fancyguyiitb/iot-smart-energy-meter/others/README.md

We have 1 files showing MCB connections between mcb, contactor and load and other jpg file demonstrating Power backup circuit
