fancyguyiitb/iot-smart-energy-meter/3d_models/PCB_MOUNT_DESIGN/README.md

# Mount Design

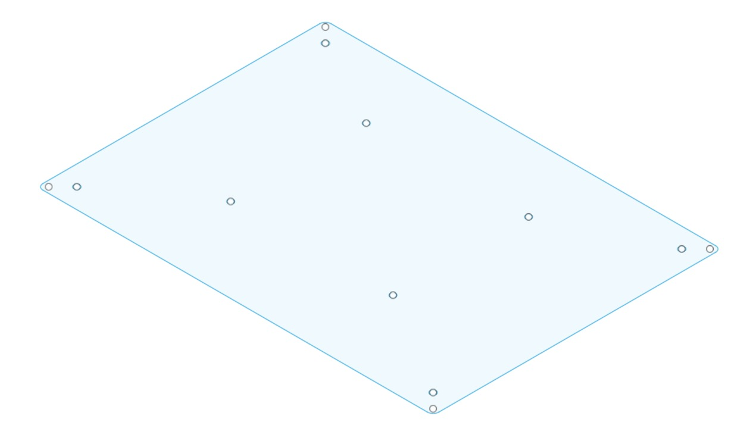
[picture p1: 3d_models/PCB_MOUNT_DESIGN/picture.jpeg]


This folder contains the DXF files for the PCB mount design.
The design is based on the PCB dimensions and includes mounting holes for screws.
