fancyguyiitb/iot-smart-energy-meter/3d_models/POWER_BACKUP/README.md

# Power Backup Design

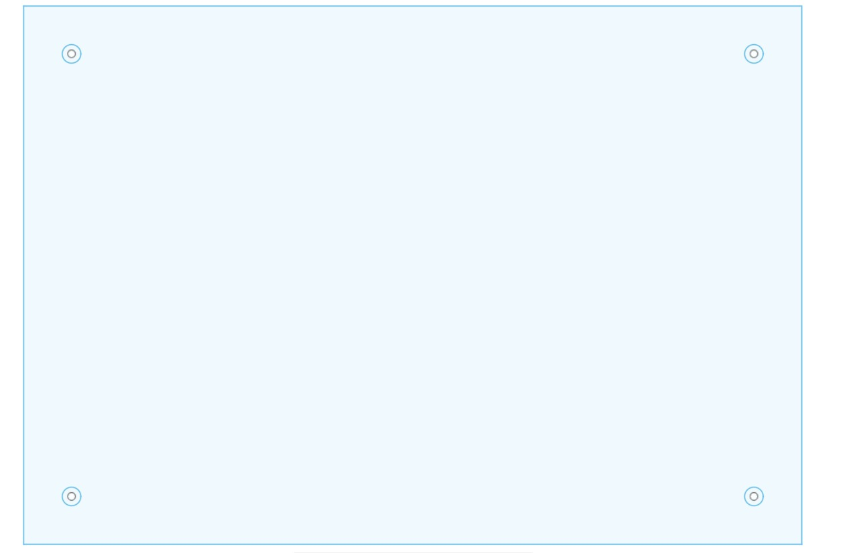
[picture p2: 3d_models/POWER_BACKUP/picture.jpeg]


This folder contains the DXF files for the Power Backup design.
The design is based on the PCB dimensions and includes mounting holes for screws.
