fancyguyiitb/iot-smart-energy-meter/src/Application/README.md

# ⚡ Voltix – Smart Energy Meter App

Voltix is a mobile app for monitoring and controlling a 3-phase IoT-based smart energy meter.

---

## 🔍 Features

- Live voltage, current, power & THD readings
- Remote supply control via relay
- Analytics on consumption & power quality
- Cloud storage with historical trends

---

## 🚀 Getting Started

```bash
git clone https://github.com/your-username/voltix.git
cd voltix
flutter pub get
flutter run
```

---

## 📦 Build APK

```bash
flutter build apk --release
```
