fancyguyiitb/iot-smart-energy-meter/others/mcb_connections.jpg

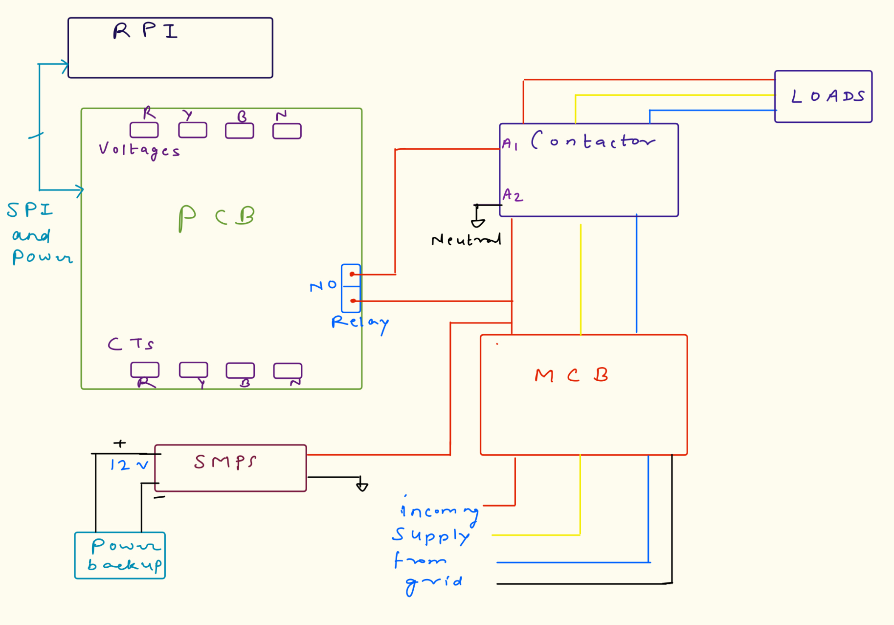
others/mcb_connections.jpg
