fancyguyiitb/iot-smart-energy-meter/others/power_backup_connections.jpg

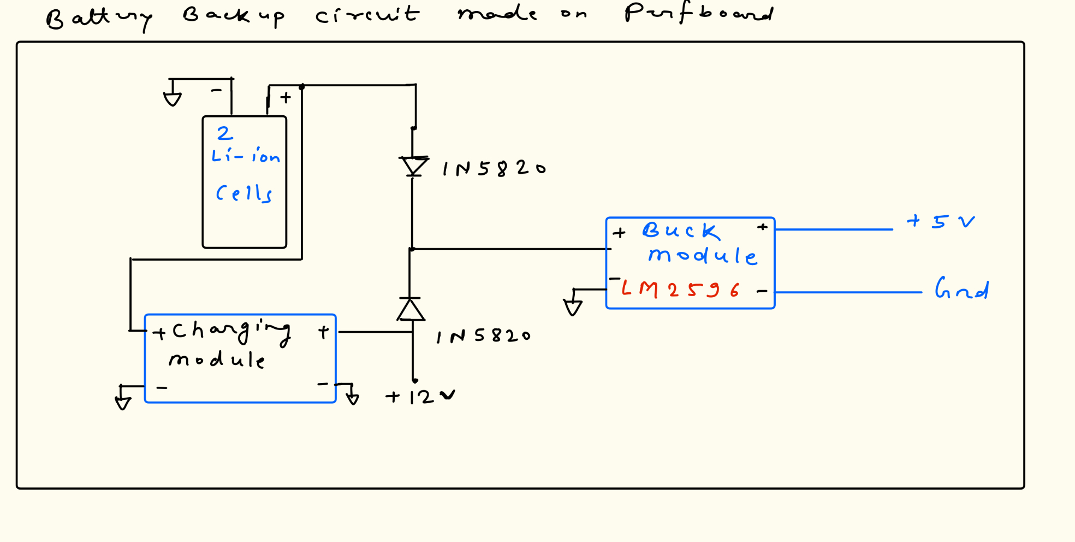
others/power_backup_connections.jpg
