fancyguyiitb/iot-smart-energy-meter/pcb/EDL_TUE_17/pcb.jpg

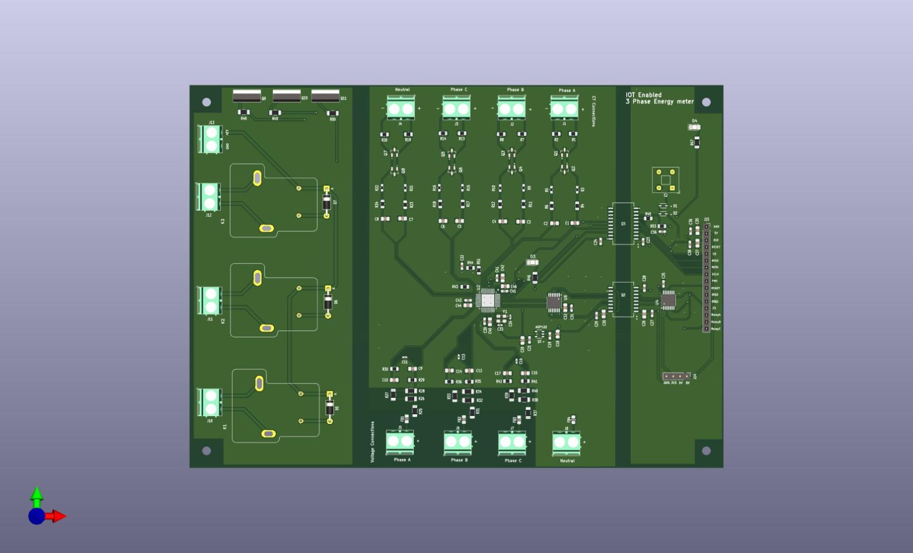
pcb/EDL_TUE_17/pcb.jpg
