fancyguyiitb/iot-smart-energy-meter/src/RPi/pages/cherish.jpg

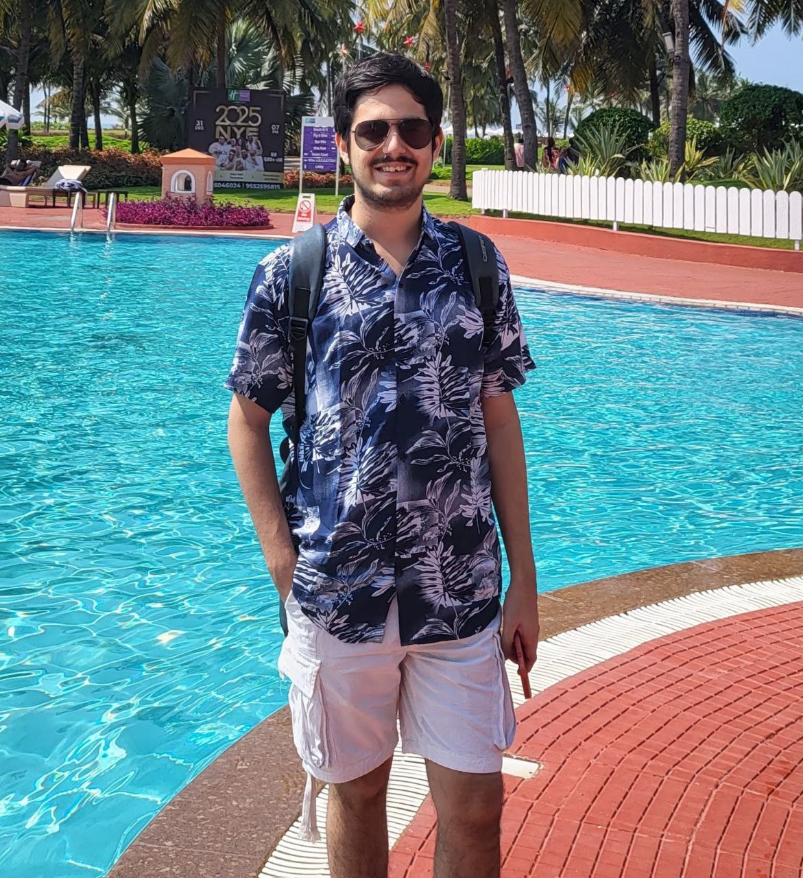
src/RPi/pages/cherish.jpg
