fancyguyiitb/iot-smart-energy-meter/src/RPi/spinner.gif

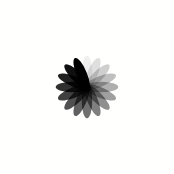
src/RPi/spinner.gif
