fancyguyiitb/iot-smart-energy-meter/bom.xls

Project Title: IoT enabled 3-phase power quality and energy meter for laboratory power analysis
Group ID: TUE-17
Name of the Group Member/s: Saurabh Kumar, Sarthak Niranjan, Aryan Tamboli, Cherish Jain, Ayush Gaur
Contact details of the Group Member responsible for BOM: 7898169485, 22b3927@iitb.ac.in
BOM
Sr.No | Usage (Name of the "Circuit block/Functional block" in which components is used) | Part description (OpAMP,ADC,DAC etc) | Manufacturing Part Number | Package type/Footprint | Availiabile in WEL? | WEL Component stock Location-ID | Vendor | Stock Availiability (With Vendor) | Link (Vendor online website) | Required Qty + Spare | Cost per each item | Total Cost
1 | Current Sensing | Current Transformers Current Transformer 100A 1:2500 97Henry | 983-T60404-E4626X002 | Not to be mounted on PCB | YES | 2K.BOX-8.2 | Mouser | In-Stock | https://www.mouser.in/ProductDetail/Vacuumschmelze/T60404-E4626-X002?qs=EPkW%252BsqxegG82U7INiKINw%3D%3D | 4 | 440.35 | 1761
2 | Power Monitoring | ANALOG DEVICES Monitoring IC, Energy and Power Quality, Multiphase, 2.97 to 3.63 V, -40 to 85 Deg C, LFCSP-EP-40 | ADE9000ACPZ | 40-pin LFCSP (6 x 6) | YES | 2K.BOX-9.55 | Mouser | In-Stock | https://www.mouser.in/ProductDetail/Analog-Devices/ADE9000ACPZ?qs=OpCP5Wdiozdy7qaFsotrPg%3D%3D&gad_source=1 | 1 | 1537.9 | 1537.9
3 | Power Management | ANALOG DEVICES LDO Voltage Regulator, Fixed, 2.3 V to 5.5 V in, 3.3 V out, 0.3 A out, TSOT-5 | ADP122AUJZ-3.3-R7 | 5 lead TSOT | YES | 2K.BOX-9.17 | Digi Key | In-Stock | https://www.digikey.in/en/products/detail/analog-devices-inc/ADP122AUJZ-3-3-R7/2237672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 | 1 | 195.83 | 195.83
4 | SPI Isolator | ANALOG DEVICES Optical Components, 7 Channels, 3 V, 5.5 V, WSOIC, 20 Pins, 34 Mbps | ADUM4151BRIZ | 20 lead SOIC | YES | 2K.BOX-9.62 | Digi Key | In-Stock | https://www.digikey.in/en/products/detail/analog-devices-inc/ADUM4151BRIZ/5031786 | 1 | 1180.48 | 1180.48
5 | Optical Components | ANALOG DEVICES Optical Components, 4 Channels, 3 V, 5.5 V, SOIC, 16 Pins, 1 Mbps | ADUM6404ARIZ | 16 lead SOIC | YES | 2K.BOX-9.63 | Mouser | In-Stock | https://www.mouser.in/ProductDetail/Analog-Devices/ADUM6404ARIZ?qs=WIvQP4zGanhHzx9OCAfFww%3D%3D | 1 | 1322.72 | 1322.72
6 | Level Shifter | IC BUF NON-INVERT 5.5V 14TSSOP | SN74LV4T125PWR | 14TSSOP | YES | 2K.BOX-8.41 | Digi Key | In-Stock | https://www.digikey.in/en/products/detail/texas-instruments/SN74LV4T125PWR/4806529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 | 2 | 67.53 | 135.06
7 | Single Board Computer | Raspberry Pi 5 |  |  | NO |  |  | In-Stock | https://robu.in/product/raspberry-pi-5-model-4gb/?gad_source=1 | 1 | 5549 | 6149
8 | Display | Raspberry Pi display 7" with capacitive touch |  |  | NO |  |  | In-Stock | https://robu.in/product/waveshare-7inch-800x480-capacitive-touch-display-for-raspberry-pi-dsi-interface/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 | 1 | 4199 | 4199
9 | Resistors (SMD) | Resistor | 0E (0805) | SMD 0805 | YES | 2M |  |  |  | 17 | 0.1 | 1.7
10 | Resistors (SMD) | Resistor | 10K | SMD 0805 | YES | 2M |  | In-Stock | https://robu.in/product/rc0805fr-0710kl-yageo-res-thick-film-0805-10k-ohm-1-0-125w1-8w-%C2%B1100ppm-c-pad-smd-t-r/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 | 8 | 0.35 | 2.8
11 | Resistors (SMD) | Resistor | 1K | SMD 0805 | YES | 2M |  | Out of Stock | https://robu.in/product/rc0805fr-071kl-yageo-res-thick-film-0805-1k-ohm-1-0-125w1-8w-%C2%B1100ppm-c-pad-smd-t-r/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 | 15
12 | Resistors (SMD) | Resistor | 200K | SMD 0805 | YES | 2M |  | In-Stock | https://robu.in/product/rc0805fr-07200kl-yageo-res-thick-film-0805-200k-ohm-1-0-125w1-8w-%C2%B1100ppm-c-pad-smd-t-r/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 | 12 | 0.35 | 4.2
13 | Resistors (SMD) | Resistor | 5.1 (0805) | SMD 0805 | YES | 2M |  | In-Stock | https://evelta.com/5-1e-5-0805-smd-resistor-royal-ohm-0805s8j051jt5e/?gad_source=1 | 8 | 1.68 | 13.44
14 | Resistors (SMD) | Resistor | 3 kΩ, 0.1 W | SMD 0805 | NO |  |  | In-Stock | https://robu.in/product/rc0805fr-073kl-yageo-res-thick-film-0805-3k-ohm-1-0-125w1-8w-%C2%B1100ppm-c-pad-smd-t-r/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 | 5 | 0.35 | 1.75
15 | Capacitor (SMD) | Capacitor | 22 nF, 50V (0805) | SMD 0805 | NO |  |  | In-Stock | https://robu.in/product/tcc0805x7r223k501ft-cctc-smt-ceramic-capacitors-0805-x7r-223k22nf%C2%B110-rated-voltage500v-thickness1-25mmtape/ | 12 | 3 | 36
16 | Capacitor (SMD) | Capacitor | 100NF, 25V (0805) | SMD 0805 | NO |  |  | In-Stock | https://robu.in/product/c0805x104k3racauto-kemet-smd-multilayer-ceramic-capacitor-0-1-%C2%B5f-25-v-0805-2012-metric-%C2%B1-10-x7r/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 | 19 | 0.26 | 4.94
17 | Capacitor (SMD) | Capacitor | 10UF, 16V (0805) | SMD 0805 | NO |  |  | In-Stock | https://robu.in/product/cl21a106kofnnne-samsang-16v-10uf-x5r-%C2%B110-0805-multilayer-ceramic-capacitors-mlcc-smd-smt-rohs/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 | 8 | 0.98 | 7.84
18 | Capacitor (SMD) | Capacitor | 1UF, 50V (0805) | SMD 0805 | NO |  |  | In-Stock | https://robu.in/product/cl21b105kbfnfne-samsang-50v-1uf-x7r-%C2%B110-0805-multilayer-ceramic-capacitors-mlcc-smd-smt-rohs/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 | 2 | 1.06 | 2.12
19 | Capacitor (SMD) | Capacitor | 22UF, 25V (0805) | SMD 0805 | NO |  |  | In-Stock | https://robu.in/product/cl21a226maynnwe-samsang-25v-22uf-x5r-%C2%B120-0805-multilayer-ceramic-capacitors-mlcc-smd-smt-rohs/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 | 1 | 3 | 3
20 | Capacitor (SMD) | Capacitor | 18 pF, 50V (0805) | SMD 0805 | NO |  |  | In-Stock | https://robu.in/product/tcc0402cog180f500at-cctc-smt-ceramic-capacitors-0402-cog-180f18pf%C2%B11-0-rated-voltage50v-thickness0-50mm-tape/ | 2 | 0.35 | 0.7
21 | Capacitor (SMD) | Capacitor | 4.7 UF, 25 V (0805) | SMD 0805 | NO |  |  | In-Stock | https://robu.in/product/cs2012x5r475k250nre-samwha-25v-4-7uf-x5r-%C2%B110-0805-multilayer-ceramic-capacitors-mlcc-smd-smt-rohs/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 | 6 | 1.03 | 6.18
22 | Capacitor (SMD) | Capacitor | 51 pF, 50 V | SMD 0402 | NO |  |  | In-Stock | https://robu.in/product/tcc0402cog510j500at-cctc-smt-ceramic-capacitors-0402-cog-510j51pf%C2%B15-0-rated-voltage50v-thickness0-50mm-tape/ | 3 | 0.12 | 0.36
23 | Ferrite Bead | Ferrite Bead 1500 Ohm | BLM21BD152SN1D | SMD 0805 | NO |  |  | In-Stock | https://www.digikey.in/en/products/detail/murata-electronics/BLM21BD152SN1D/584258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 | 4 | 18.12 | 72.48
24 | Diodes | MULTICOMP PRO Small Signal Schottky Diodes, Single, 30 V, 300 mA, 1 V, 600 mA, 125 Â°C | BAT54WS | SOD-323 | YES | 2K.BOX-9.110 |  |  | https://www.vishay.com/docs/85667/bat54ws.pdf | 2
25 | Crystal Oscillator (Clock for ADE Chip) | Crystal, 24.576 MHz, 12 pF | ECS-245.7-12-33Q-JES-TR | 4-SMD | NO |  |  | In-Stock | https://www.digikey.com/en/products/detail/ecs-inc/ECS-245-7-12-33Q-JES-TR/6050970 | 1 | 75 | 75
26 | Diodes | Diodes, dual series connection, 100 V | MMBD4148SE | SOT-23-3 | YES | 2K.BOX-9.65 |  | In-Stock | https://www.mouser.in/ProductDetail/onsemi-Fairchild/MMBD4148SE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 | 8 | 10.84 | 86.72
27 | Connectors (Voltage and Current Connections) | 2 pin screw terminal | XY128VC-5.0-XINYA-2 Pin Screw | THT | YES | 2L.Box-4, 15.54 |  | In-Stock | https://robu.in/product/xy128vc-5-0-xinya-2-pin-screw-terminal-blockgreen/?gad_source=4 | 10 | 11 | 110
28 | Switch (RESET) | SWITCH TACTILE SPST-NO 0.05A 12V | 2223-TS02-66-50-BK-100-LCR-D-ND | THT | YES | 2K.BOX-8.63 |  | In-Stock | TS02-66-50-BK-100-LCR-D Same Sky (Formerly CUI Devices) | Switches | DigiKey (https://www.digikey.in/en/products/detail/same-sky-formerly-cui-devices/TS02-66-50-BK-100-LCR-D/15634294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) | 1 | 11.22 | 11.22
29 | Connector (For Power Input) | Micro USB 2.0 B Type 5 Pin Connector | CONN RCPT USB2.0 MICRO B SMD R/A | SMD | YES | 2K.BOX-9.138 |  | In-Stock | https://www.digikey.in/en/products/detail/amphenol-icc-fci/10118194-0001LF/2785389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 | 1 | 35.37 | 35.37
30 | Relay (To Turn on/off load) | Relay High Current | T9VV1K15-12S | THT | NO |  |  | In-Stock | https://robu.in/product/t9vv1k15-12s-potterbrumfield-te-connectivity-t9vv1k15-12s-power-relay-spst-no-12vdc-40a-th/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 | 3 | 211 | 633
31 | Transistor (For Relay Drive) | BC547 | BC547 NPN Transistor | THT | YES | 2L.BOX-3.8 |  | In-Stock | https://robu.in/product/bc547-npn-transistor-pack-of-20/?gad_source=4 | 5 | 2 | 10
32 | charging module HW370 TP5100 |  |  |  | YES |  |  |  |  | 1
33 | diodes |  | 1n5820 |  | YES |  |  |  |  | 2
34 | buck converter module |  | lm2596 |  | YES |  |  |  |  | 1
35 | lithium ion cells 3.7v |  |  |  | YES |  |  |  |  | 2
36 | Contactor
37 | Legrand Box
 |  |  |  |  |  |  |  |  |  |  | TOTAL | 17599.81
