fancyguyiitb/iot-smart-energy-meter/3d_models/PCB_MOUNT_DESIGN/design .dxf

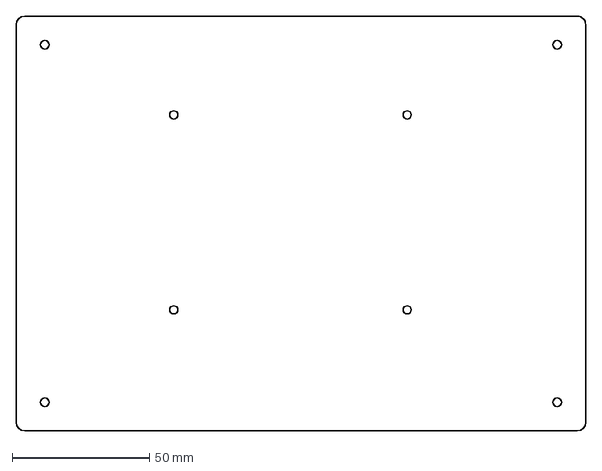
[picture p27: CAD file, 2025-04-13]
3d_models/PCB_MOUNT_DESIGN/design .dxf
207.3 x 150.9 mm
