fancyguyiitb/iot-smart-energy-meter/3d_models/POWER_BACKUP/design.dxf

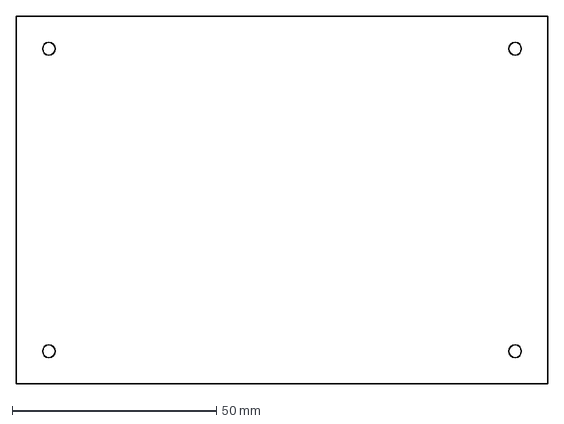
[picture p28: CAD file, 2025-04-13]
3d_models/POWER_BACKUP/design.dxf
130.0 x 90.0 mm
