fancyguyiitb/iot-smart-energy-meter/pcb/EDL_TUE_17/PCB.kicad_pcb

## KiCad design pcb/EDL_TUE_17/PCB.kicad_pcb (2025-04-13)

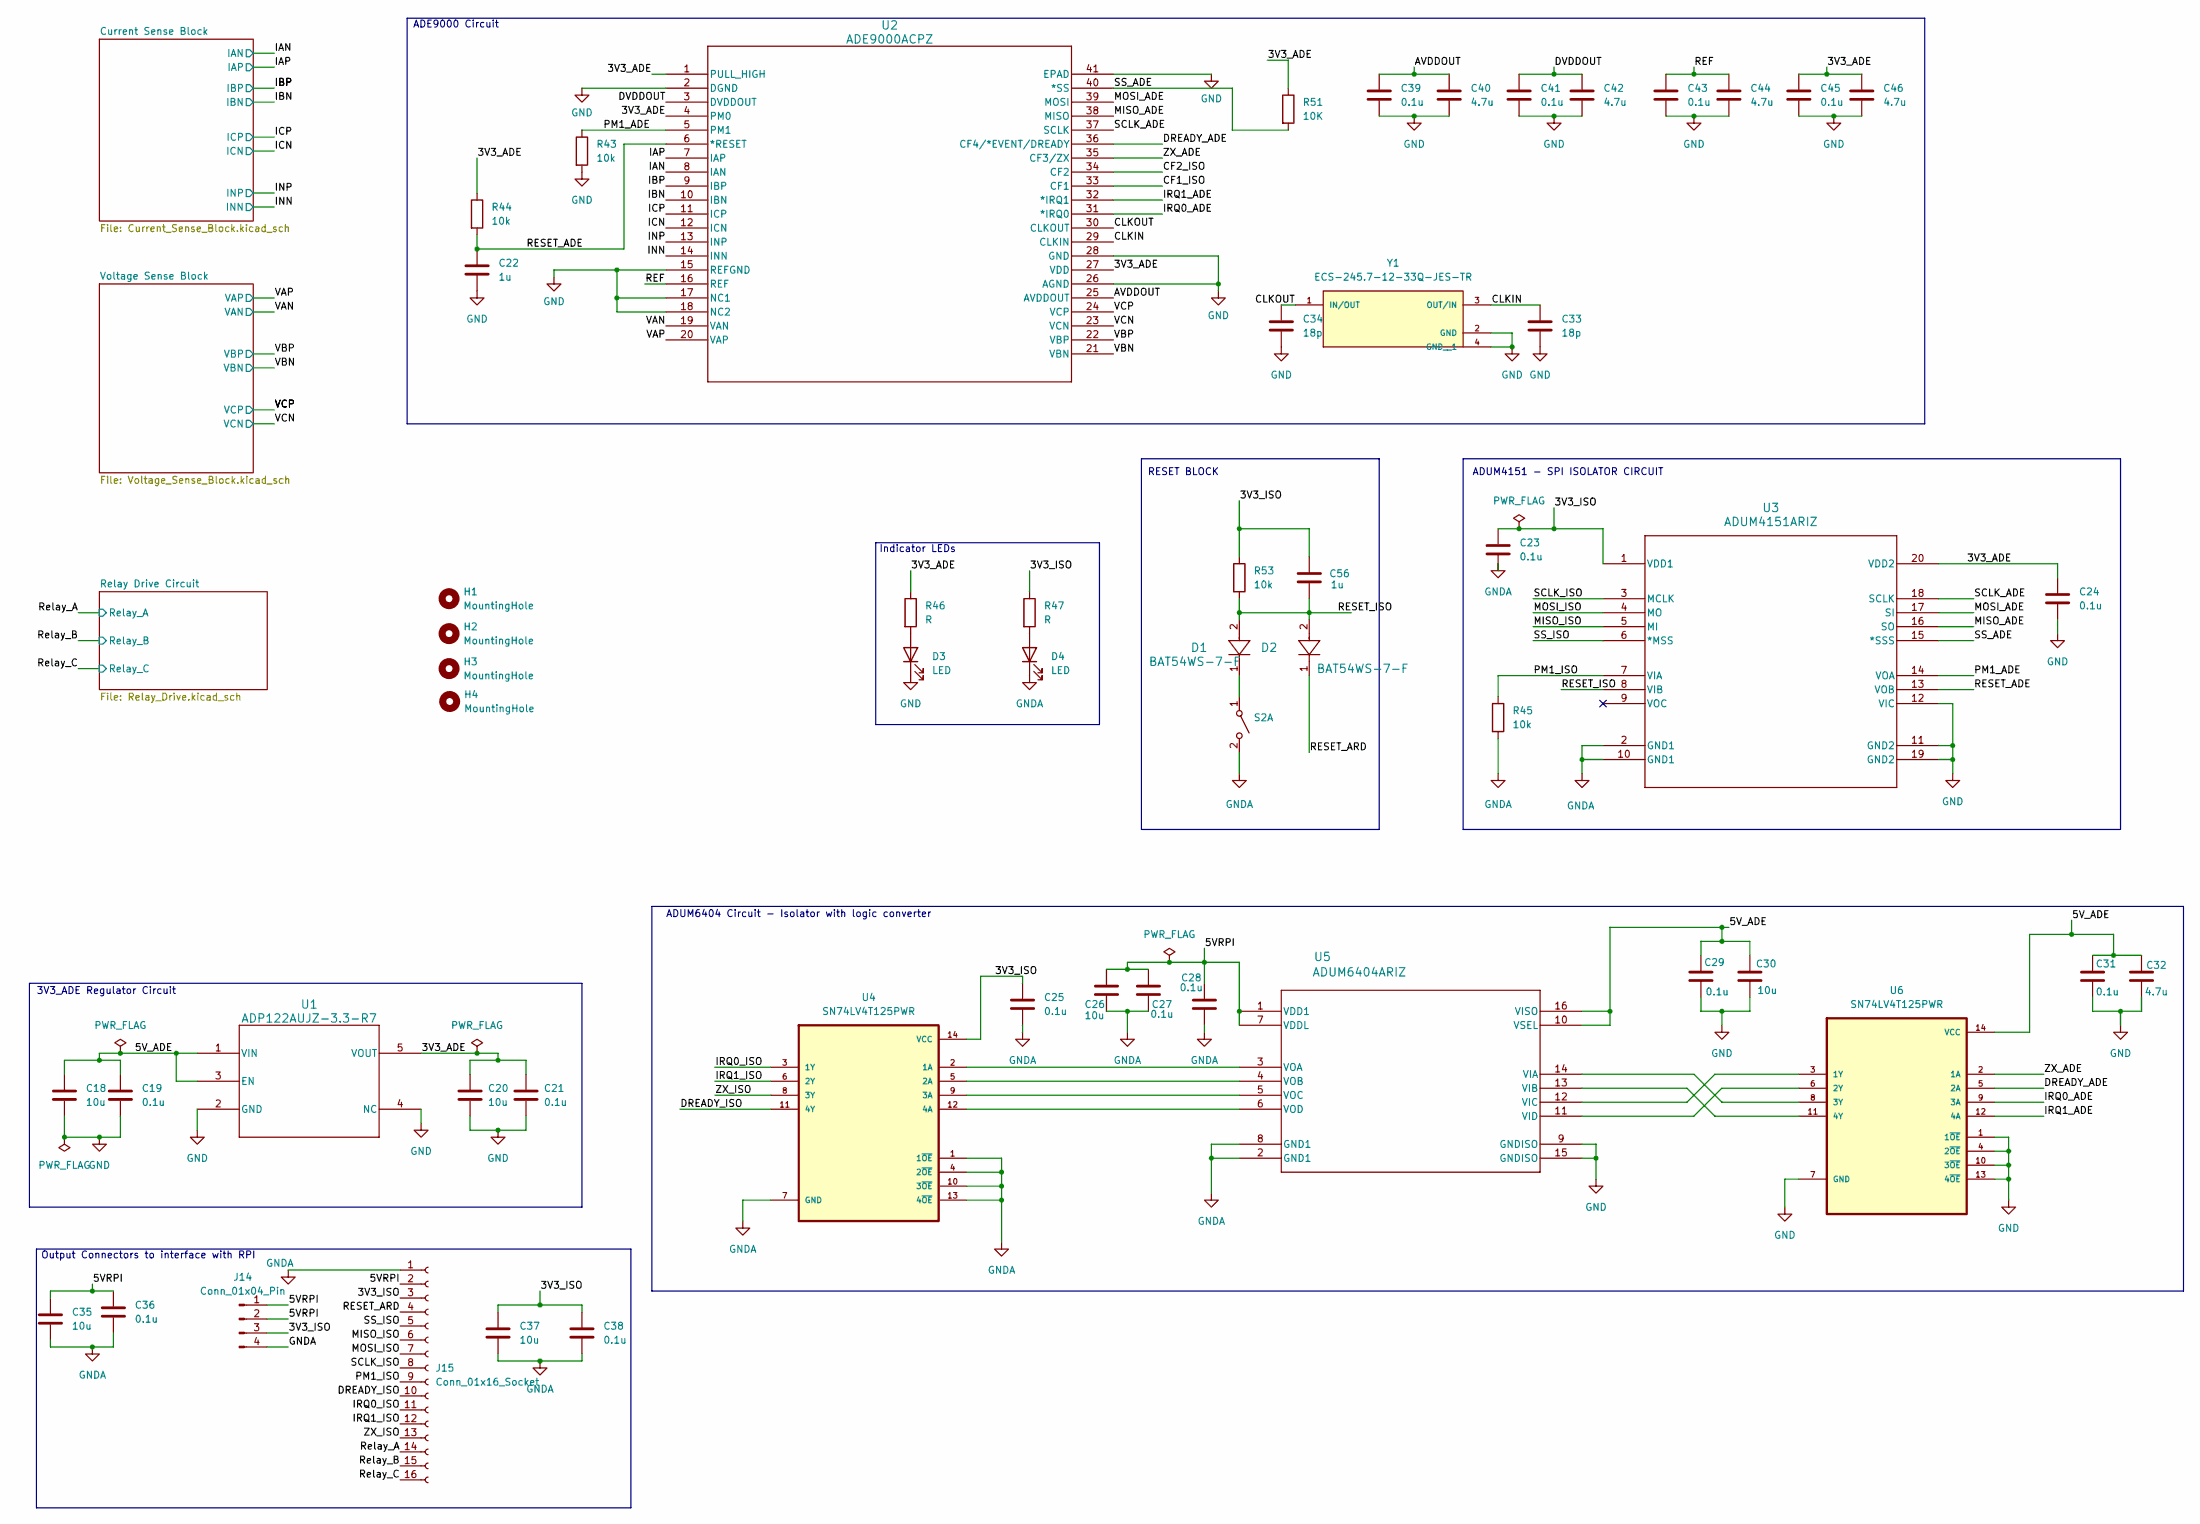
[picture p30: schematic PCB.kicad_sch, EDL: IOT-based 3-Phase Energy meter]

Parts:
C18, C20, C26, C30, C35, C37: 10u; C_0805_2012Metric_Pad1.18x1.45mm_HandSolder
C19, C21, C23, C24, C25, C27, C28, C29, C31, C36, C38, C39, C41, C43, C45: 0.1u; C_0603_1608Metric_Pad1.08x0.95mm_HandSolder
C22, C56: 1u; C_0603_1608Metric_Pad1.08x0.95mm_HandSolder
C32, C40, C42, C44, C46: 4.7u; C_0805_2012Metric_Pad1.18x1.45mm_HandSolder
C33, C34: 18p; C_0402_1005Metric_Pad0.74x0.62mm_HandSolder
D1, D2: BAT54WS-7-F; SOD323_DIO
D3, D4: LED; LED_1206_3216Metric_Pad1.42x1.75mm_HandSolder
H1, H2, H3, H4: MountingHole; MountingHole_3.2mm_M3
J14: Conn_01x04_Pin; PinHeader_1x04_P2.54mm_Vertical
J15: Conn_01x16_Socket; PinSocket_1x16_P2.54mm_Vertical
R43, R44, R45, R53: 10k; R_0805_2012Metric_Pad1.20x1.40mm_HandSolder
R46, R47: R; R_1206_3216Metric_Pad1.30x1.75mm_HandSolder
R51: 10K; R_0805_2012Metric_Pad1.20x1.40mm_HandSolder
S2: SW_Push_2P1T_Toggle_CK_PVA1xxH4xxxxxxV2
U1: ADP122AUJZ-3.3-R7; UJ_5_ADI
U2: ADE9000ACPZ; ADE9000ACPZ_ADI
U3: ADUM4151ARIZ; RI_20_1_ADI
U4, U6: SN74LV4T125PWR; SOP65P640X120-14N
U5: ADUM6404ARIZ; RI_16_1_ADI
Y1: ECS-245.7-12-33Q-JES-TR; XTAL_ECS-245.7-12-33Q-JES-TR

Connections:
/3V3_ADE: C20.1, C21.1, C24.1, C45.1, C46.1, R44.1, R46.1, R51.1, U1.5 (VOUT), U2.1 (PULL_HIGH), U2.4 (PM0), U2.27 (VDD), U3.20 (VDD2)
/3V3_ISO: C23.1, C25.1, C37.1, C38.1, C56.1, J14.3, J15.3, R47.1, R53.1, U3.1 (VDD1), U4.14 (VCC)
/5VRPI: C26.1, C27.1, C28.1, C35.1, C36.1, J14.1, J14.2, J15.2, U5.1 (VDD1), U5.7 (VDDL)
/5V_ADE: C18.1, C19.1, C29.1, C30.1, C31.1, C32.1, U1.1 (VIN), U1.3 (EN), U5.10 (VSEL), U5.16 (VISO), U6.14 (VCC)
/AVDDOUT: C39.1, C40.1, U2.25 (AVDDOUT)
/CF1_ISO: U2.33 (CF1)
/CF2_ISO: U2.34 (CF2)
/CLKIN: C33.1, U2.29 (CLKIN), Y1.3 (OUT/IN)
/CLKOUT: C34.1, U2.30 (CLKOUT), Y1.1 (IN/OUT)
/DREADY_ADE: U2.36 (CF4/*EVENT/DREADY), U6.5 (2A)
/DREADY_ISO: J15.10, U4.11 (4Y)
/DVDDOUT: C41.1, C42.1, U2.3 (DVDDOUT)
/IAN: U2.8 (IAN); also elsewhere on the board
/IAP: U2.7 (IAP); also elsewhere on the board
/IBN: U2.10 (IBN); also elsewhere on the board
/IBP: U2.9 (IBP); also elsewhere on the board
/ICN: U2.12 (ICN); also elsewhere on the board
/ICP: U2.11 (ICP); also elsewhere on the board
/INN: U2.14 (INN); also elsewhere on the board
/INP: U2.13 (INP); also elsewhere on the board
/IRQ0_ADE: U2.31 (*IRQ0), U6.9 (3A)
/IRQ0_ISO: J15.11, U4.3 (1Y)
/IRQ1_ADE: U2.32 (*IRQ1), U6.12 (4A)
/IRQ1_ISO: J15.12, U4.6 (2Y)
/MISO_ADE: U2.38 (MISO), U3.16 (SO)
/MISO_ISO: J15.6, U3.5 (MI)
/MOSI_ADE: U2.39 (MOSI), U3.17 (SI)
/MOSI_ISO: J15.7, U3.4 (MO)
/PM1_ADE: R43.1, U2.5 (PM1), U3.14 (VOA)
/PM1_ISO: J15.9, R45.1, U3.7 (VIA)
/REF: C43.1, C44.1, U2.16 (REF)
/RESET_ADE: C22.1, R44.2, U2.6 (*RESET), U3.13 (VOB)
/RESET_ARD: D2.1, J15.4
/RESET_ISO: C56.2, D1.2, D2.2, R53.2, U3.8 (VIB)
/Relay_A: J15.14; also elsewhere on the board
/Relay_B: J15.15; also elsewhere on the board
/Relay_C: J15.16; also elsewhere on the board
/SCLK_ADE: U2.37 (SCLK), U3.18 (SCLK)
/SCLK_ISO: J15.8, U3.3 (MCLK)
/SS_ADE: R51.2, U2.40 (*SS), U3.15 (*SSS)
/SS_ISO: J15.5, U3.6 (*MSS)
/VAN: U2.19 (VAN); also elsewhere on the board
/VAP: U2.20 (VAP); also elsewhere on the board
/VBN: U2.21 (VBN); also elsewhere on the board
/VBP: U2.22 (VBP); also elsewhere on the board
/VCN: U2.23 (VCN); also elsewhere on the board
/VCP: U2.24 (VCP); also elsewhere on the board
/ZX_ADE: U2.35 (CF3/ZX), U6.2 (1A)
/ZX_ISO: J15.13, U4.8 (3Y)
GND: C18.2, C19.2, C20.2, C21.2, C22.2, C24.2, C29.2, C30.2, C31.2, C32.2, C33.2, C34.2, C39.2, C40.2, C41.2, C42.2, C43.2, C44.2, C45.2, C46.2, D3.1 (K), R43.2, U1.2 (GND), U1.4 (NC), U2.2 (DGND), U2.15 (REFGND), U2.17 (NC1), U2.18 (NC2), U2.26 (AGND), U2.28 (GND), U2.41 (EPAD), U3.11 (GND2), U3.12 (VIC), U3.19 (GND2), U5.9 (GNDISO), U5.15 (GNDISO), U6.1 (1~OE), U6.4 (2~OE), U6.7 (GND), U6.10 (3~OE), U6.13 (4~OE), Y1.2 (GND), Y1.4 (GND__1); also elsewhere on the board
GNDA: C23.2, C25.2, C26.2, C27.2, C28.2, C35.2, C36.2, C37.2, C38.2, D4.1 (K), J14.4, J15.1, R45.2, S2.2 (B), U3.2 (GND1), U3.10 (GND1), U4.1 (1~OE), U4.4 (2~OE), U4.7 (GND), U4.10 (3~OE), U4.13 (4~OE), U5.2 (GND1), U5.8 (GND1); also elsewhere on the board
unnamed: D3.2 (A), R46.2
unnamed: D4.2 (A), R47.2
unnamed: D1.1, S2.1 (A)
unnamed: U4.2 (1A), U5.3 (VOA)
unnamed: U4.5 (2A), U5.4 (VOB)
unnamed: U4.9 (3A), U5.5 (VOC)
unnamed: U4.12 (4A), U5.6 (VOD)
unnamed: U5.14 (VIA), U6.8 (3Y)
unnamed: U5.13 (VIB), U6.11 (4Y)
unnamed: U5.12 (VIC), U6.3 (1Y)
unnamed: U5.11 (VID), U6.6 (2Y)

Notes on the sheet:
RESET BLOCK
Output Connectors to interface with RPI
ADUM4151 - SPI ISOLATOR CIRCUIT
Indicator LEDs
ADUM6404 Circuit - Isolator with logic converter
ADE9000 Circuit
3V3_ADE Regulator Circuit

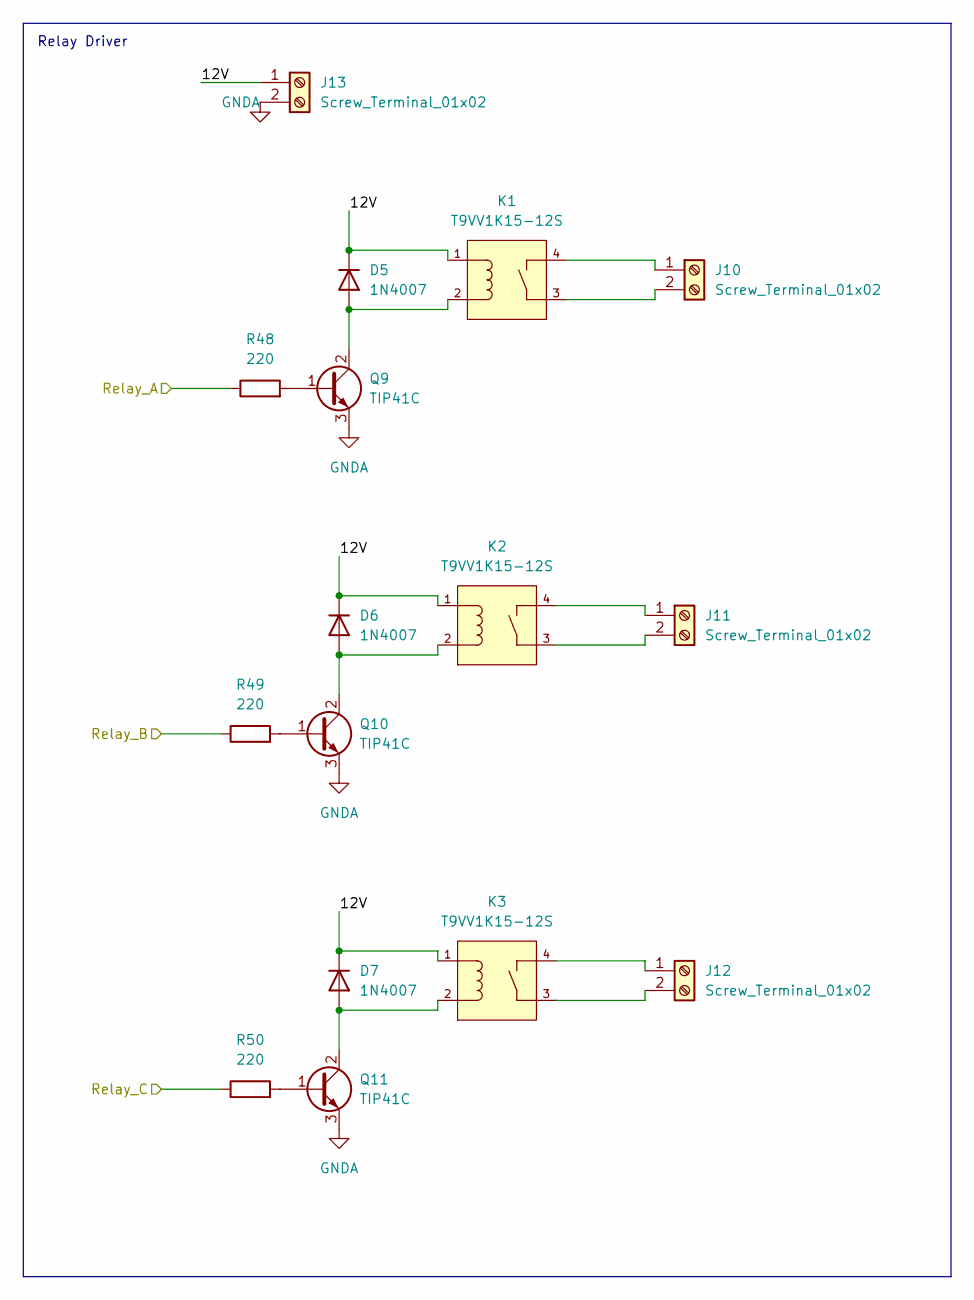
[picture p31: schematic Relay_Drive.kicad_sch]

Parts:
D5, D6, D7: 1N4007; D_DO-41_SOD81_P10.16mm_Horizontal
J10, J11, J12, J13: Screw_Terminal_01x02; TerminalBlock_Phoenix_PT-1,5-2-5.0-H_1x02_P5.00mm_Horizontal
K1, K2, K3: T9VV1K15-12S; RELAY_T9VV1K15-12S
Q9, Q10, Q11: TIP41C; TO-220-3_Vertical
R48, R49, R50: 220; R_1206_3216Metric_Pad1.30x1.75mm_HandSolder

Connections:
/Relay Drive Circuit/12V: D5.1 (K), D6.1 (K), D7.1 (K), J13.1, K1.1, K2.1, K3.1
/Relay_A: R48.1; also elsewhere on the board
/Relay_B: R49.1; also elsewhere on the board
/Relay_C: R50.1; also elsewhere on the board
GNDA: J13.2, Q9.3 (E), Q10.3 (E), Q11.3 (E); also elsewhere on the board
unnamed: D5.2 (A), K1.2, Q9.2 (C)
unnamed: D6.2 (A), K2.2, Q10.2 (C)
unnamed: D7.2 (A), K3.2, Q11.2 (C)
unnamed: J10.1, K1.4
unnamed: J10.2, K1.3
unnamed: J11.1, K2.4
unnamed: J11.2, K2.3
unnamed: J12.1, K3.4
unnamed: J12.2, K3.3
unnamed: Q9.1 (B), R48.2
unnamed: Q10.1 (B), R49.2
unnamed: Q11.1 (B), R50.2

Notes on the sheet:
Relay Driver

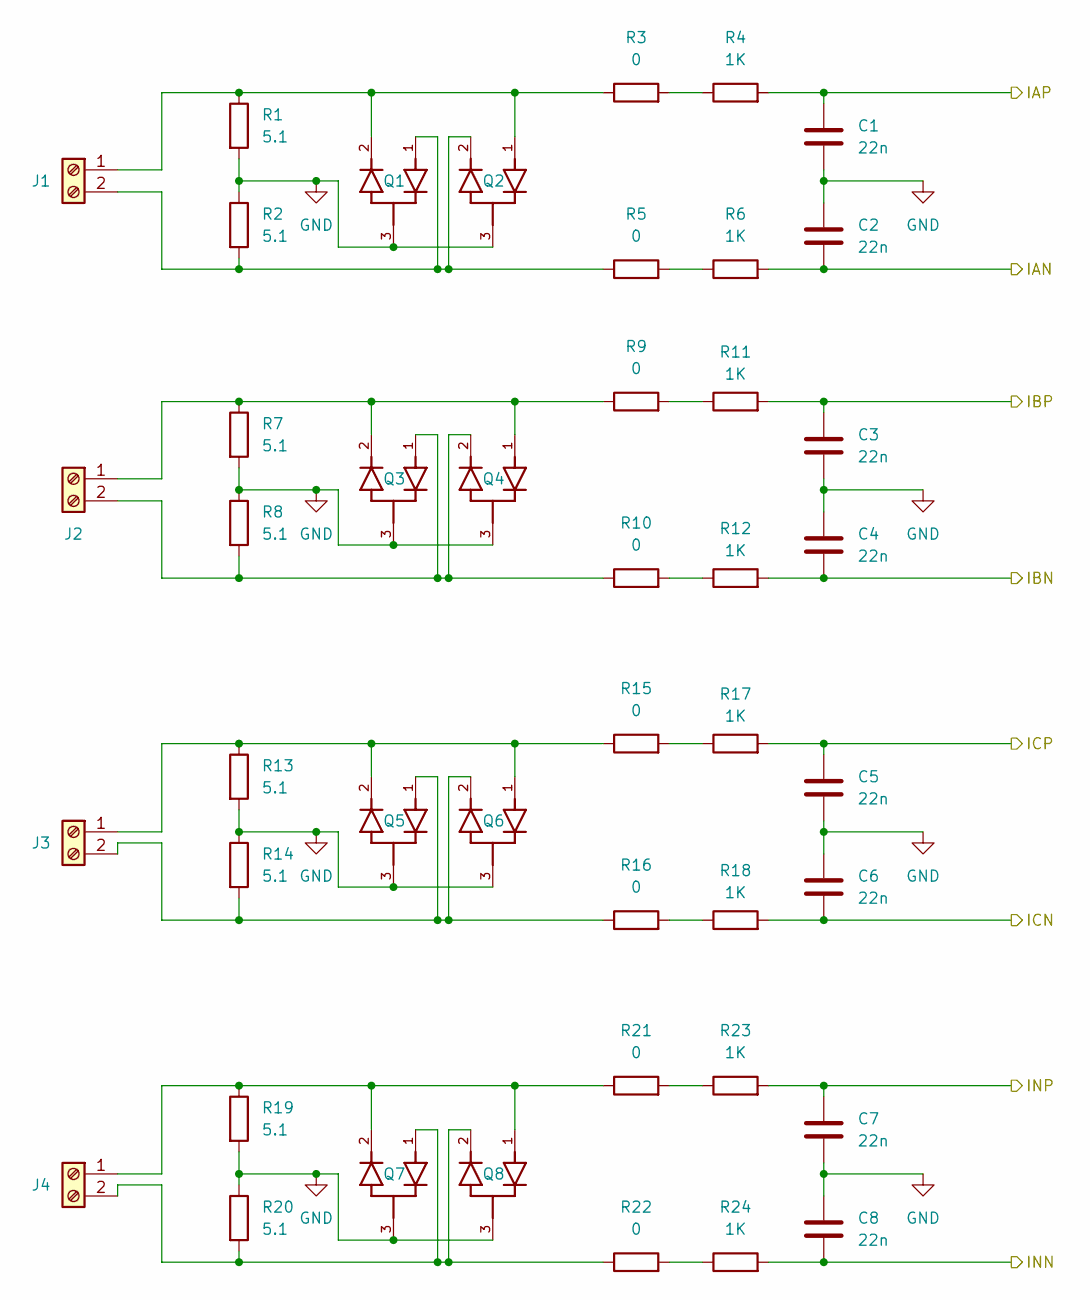
[picture p32: schematic Current_Sense_Block.kicad_sch]

Parts:
C1, C2, C3, C4, C5, C6, C7, C8: 22n; C_0805_2012Metric_Pad1.18x1.45mm_HandSolder
J1, J2, J3, J4: Screw_Terminal_01x02; TerminalBlock_Phoenix_PT-1,5-2-5.0-H_1x02_P5.00mm_Horizontal
Q1, Q2, Q3, Q4, Q5, Q6, Q7, Q8: MMBD4148SE_RFG; SOT95P237X112-3N; PARTREV E2001
R1, R2, R7, R8, R13, R14, R19, R20: 5.1; R_0805_2012Metric_Pad1.20x1.40mm_HandSolder
R3, R5, R9, R10, R15, R16, R21, R22: 0; R_0603_1608Metric_Pad0.98x0.95mm_HandSolder
R4, R6, R11, R12, R17, R18, R23, R24: 1K; R_0805_2012Metric_Pad1.20x1.40mm_HandSolder

Connections:
/IAN: C2.2, R6.2; also elsewhere on the board
/IAP: C1.1, R4.2; also elsewhere on the board
/IBN: C4.2, R12.2; also elsewhere on the board
/IBP: C3.1, R11.2; also elsewhere on the board
/ICN: C6.2, R18.2; also elsewhere on the board
/ICP: C5.1, R17.2; also elsewhere on the board
/INN: C8.2, R24.2; also elsewhere on the board
/INP: C7.1, R23.2; also elsewhere on the board
GND: C1.2, C2.1, C3.2, C4.1, C5.2, C6.1, C7.2, C8.1, Q1.3, Q2.3, Q3.3, Q4.3, Q5.3, Q6.3, Q7.3, Q8.3, R1.2, R2.1, R7.2, R8.1, R13.2, R14.1, R19.2, R20.1; also elsewhere on the board
unnamed: J1.1, Q1.2, Q2.1, R1.1, R3.1
unnamed: J1.2, Q1.1, Q2.2, R2.2, R5.1
unnamed: J2.1, Q3.2, Q4.1, R7.1, R9.1
unnamed: J2.2, Q3.1, Q4.2, R8.2, R10.1
unnamed: J3.1, Q5.2, Q6.1, R13.1, R15.1
unnamed: J3.2, Q5.1, Q6.2, R14.2, R16.1
unnamed: J4.1, Q7.2, Q8.1, R19.1, R21.1
unnamed: J4.2, Q7.1, Q8.2, R20.2, R22.1
unnamed: R3.2, R4.1
unnamed: R5.2, R6.1
unnamed: R10.2, R12.1
unnamed: R9.2, R11.1
unnamed: R15.2, R17.1
unnamed: R16.2, R18.1
unnamed: R21.2, R23.1
unnamed: R22.2, R24.1

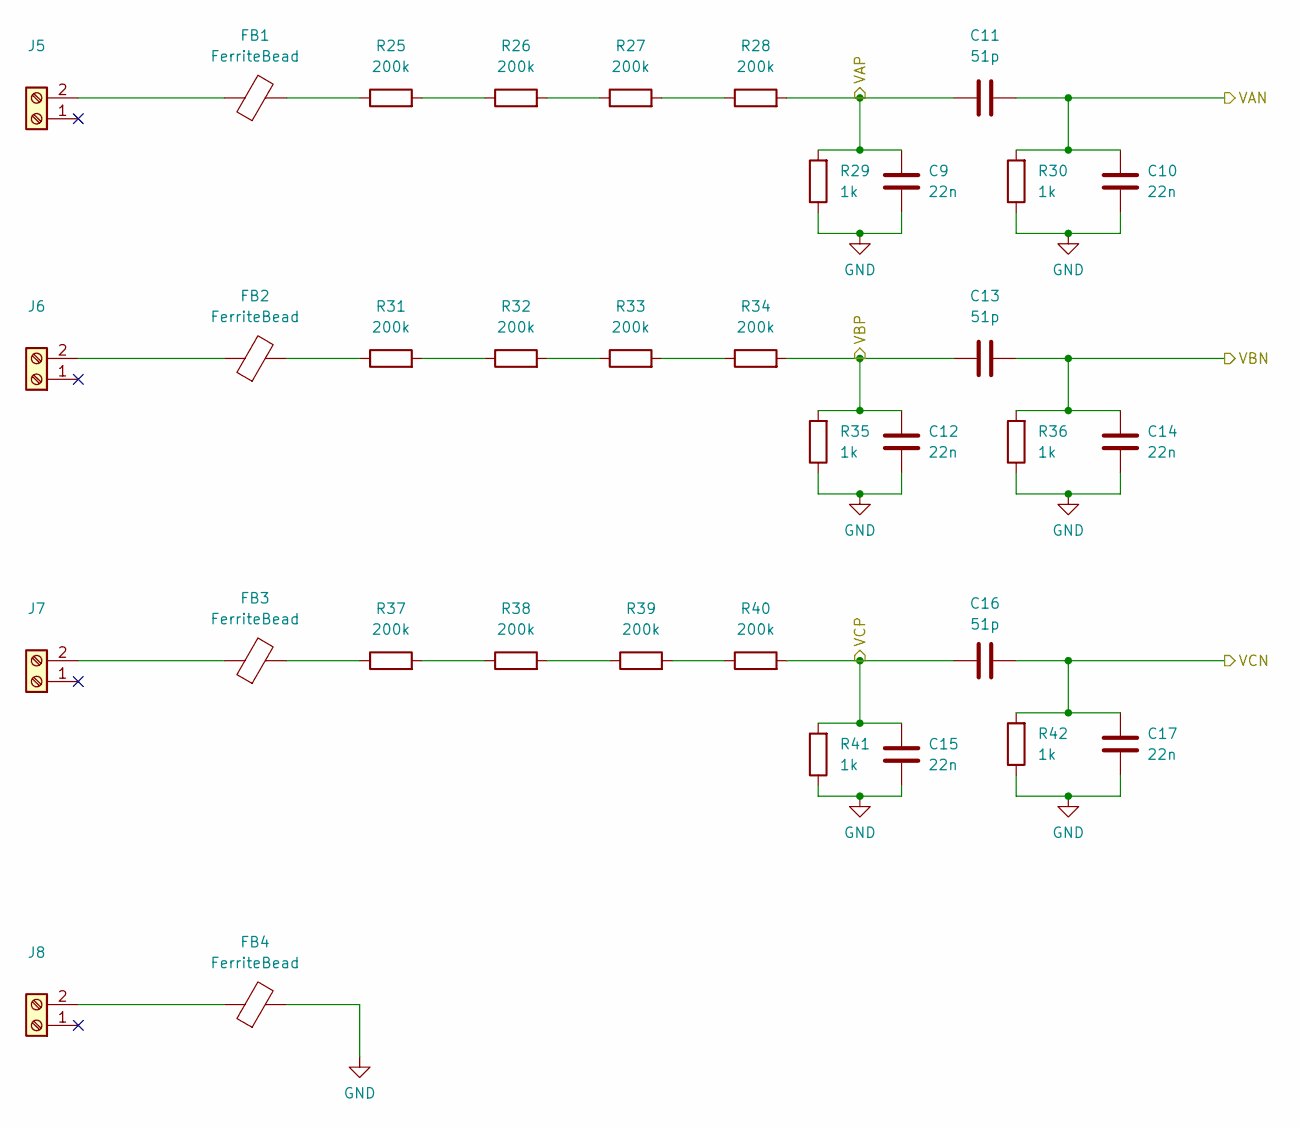
[picture p33: schematic Voltage_Sense_Block.kicad_sch]

Parts:
C9, C10, C12, C14, C15, C17: 22n; C_0805_2012Metric_Pad1.18x1.45mm_HandSolder
C11, C13, C16: 51p; C_0402_1005Metric_Pad0.74x0.62mm_HandSolder
FB1, FB2, FB3, FB4: FerriteBead; L_0805_2012Metric_Pad1.15x1.40mm_HandSolder
J5, J6, J7, J8: Screw_Terminal_01x02; TerminalBlock_Phoenix_PT-1,5-2-5.0-H_1x02_P5.00mm_Horizontal
R25, R26, R27, R28, R31, R32, R33, R34, R37, R38, R39, R40: 200k; R_1206_3216Metric_Pad1.30x1.75mm_HandSolder
R29, R30, R35, R36, R41, R42: 1k; R_0805_2012Metric_Pad1.20x1.40mm_HandSolder

Connections:
/VAN: C10.1, C11.2, R30.2; also elsewhere on the board
/VAP: C9.1, C11.1, R28.2, R29.2; also elsewhere on the board
/VBN: C13.2, C14.1, R36.2; also elsewhere on the board
/VBP: C12.1, C13.1, R34.2, R35.2; also elsewhere on the board
/VCN: C16.2, C17.1, R42.2; also elsewhere on the board
/VCP: C15.1, C16.1, R40.2, R41.2; also elsewhere on the board
GND: C9.2, C10.2, C12.2, C14.2, C15.2, C17.2, FB4.2, R29.1, R30.1, R35.1, R36.1, R41.1, R42.1; also elsewhere on the board
unnamed: FB1.2, R25.1
unnamed: FB2.2, R31.1
unnamed: FB3.2, R37.1
unnamed: FB1.1, J5.2
unnamed: FB2.1, J6.2
unnamed: FB3.1, J7.2
unnamed: FB4.1, J8.2
unnamed: R25.2, R26.1
unnamed: R26.2, R27.1
unnamed: R27.2, R28.1
unnamed: R31.2, R32.1
unnamed: R32.2, R33.1
unnamed: R33.2, R34.1
unnamed: R37.2, R38.1
unnamed: R38.2, R39.1
unnamed: R39.2, R40.1

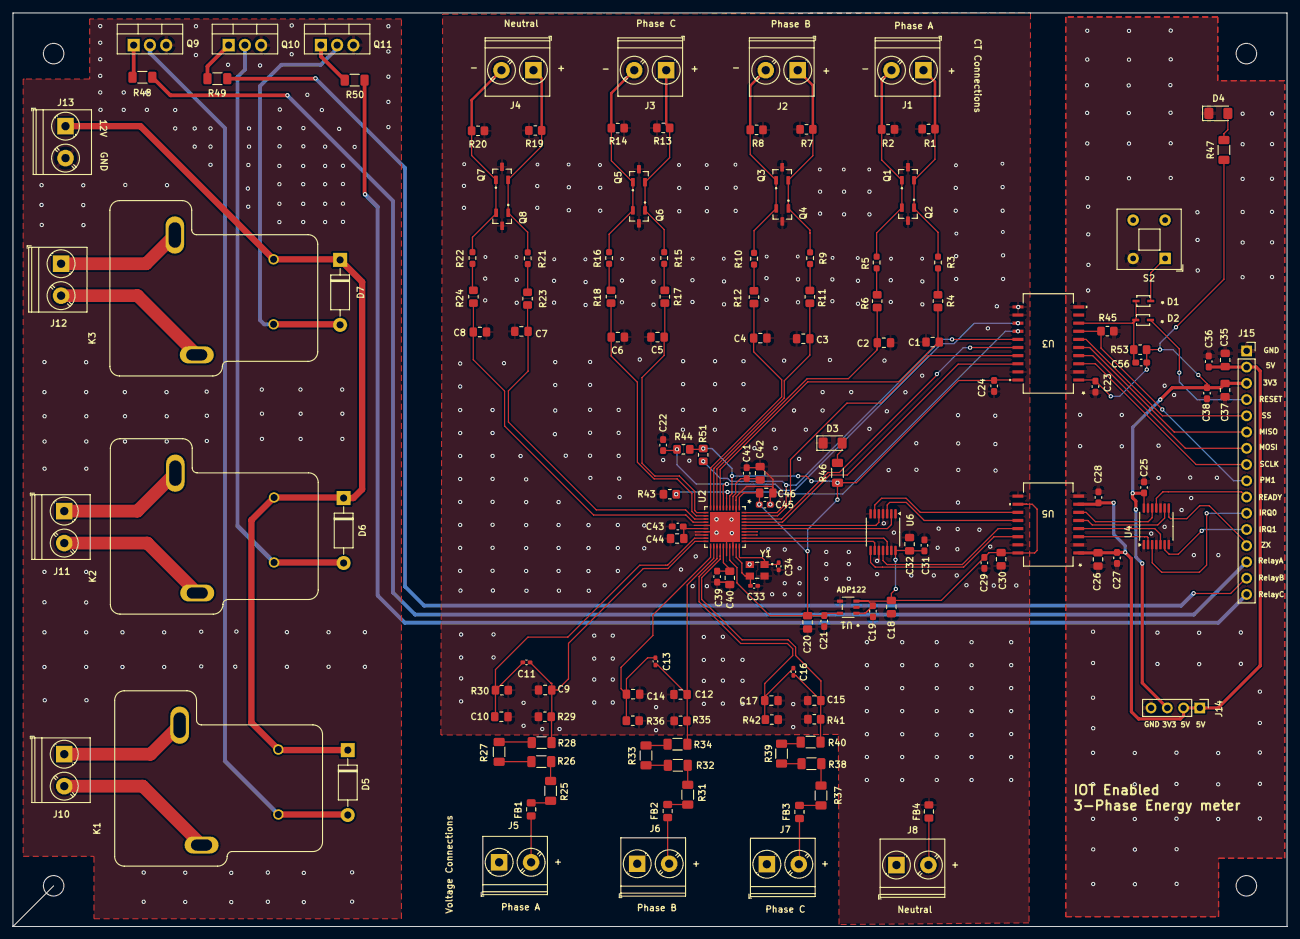
[picture p34: board PCB.kicad_pcb from above]

Board: 2 copper layers, 199.3 x 142.9 mm, 150 parts (0 on the bottom side), 105 nets.
