fancyguyiitb/iot-smart-energy-meter/(commit log)

2025-04-05 Grading Workflow Attached
    Assignment workflow check added
2025-04-13 Initial Commit
    Todos:
    - Fix README
    - Add BOM
    [Current_Sense_Block.kicad_sch, PCB.kicad_pcb, PCB.kicad_sch, Relay_Drive.kicad_sch, Voltage_Sense_Block.kicad_sch]
2025-04-13 Add bom
    [bom.xls]
2025-04-13 Add reports and 3d models
    [design .dxf, design.dxf]
